ashlynblack/psx-mod/research/notes/2024-06-29.pdf

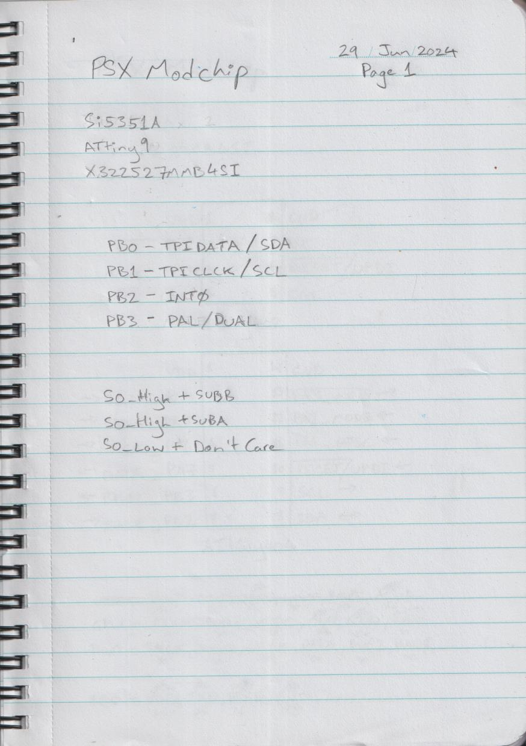
[picture p7: page 1]
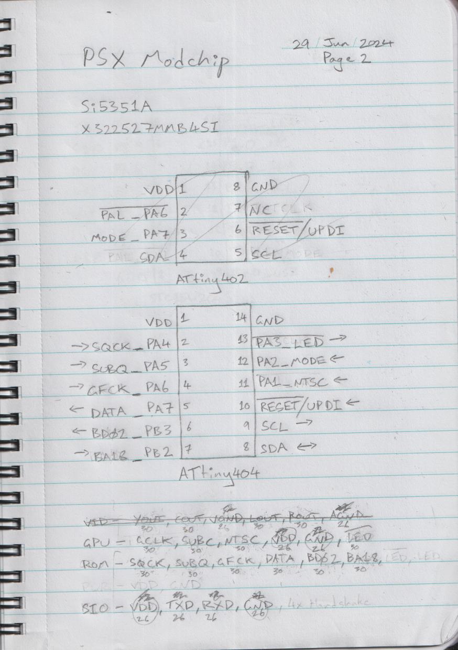
[picture p8: page 2]
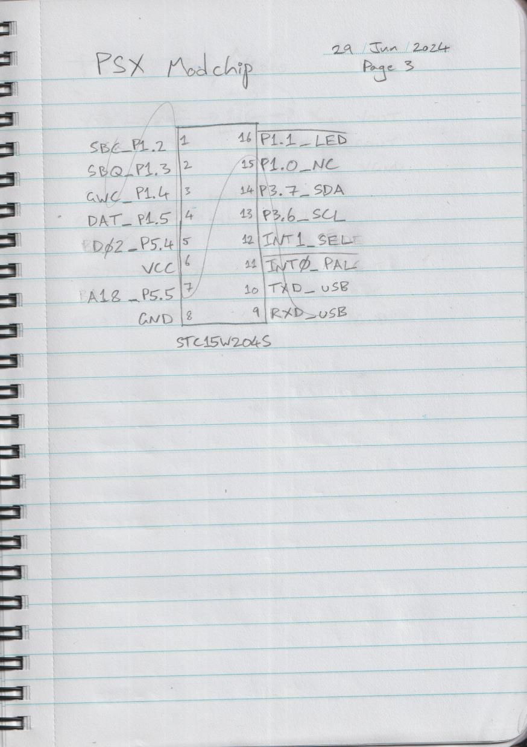
[picture p9: page 3]
