ashlynblack/psx-mod/artifacts/back.png

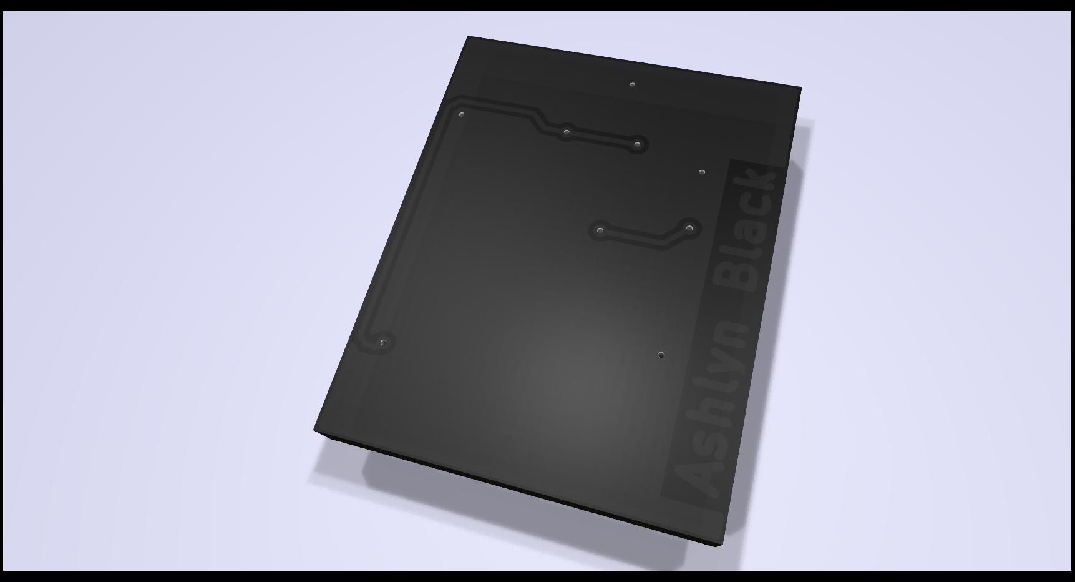
artifacts/back.png
