ashlynblack/psx-mod/artifacts/front.png

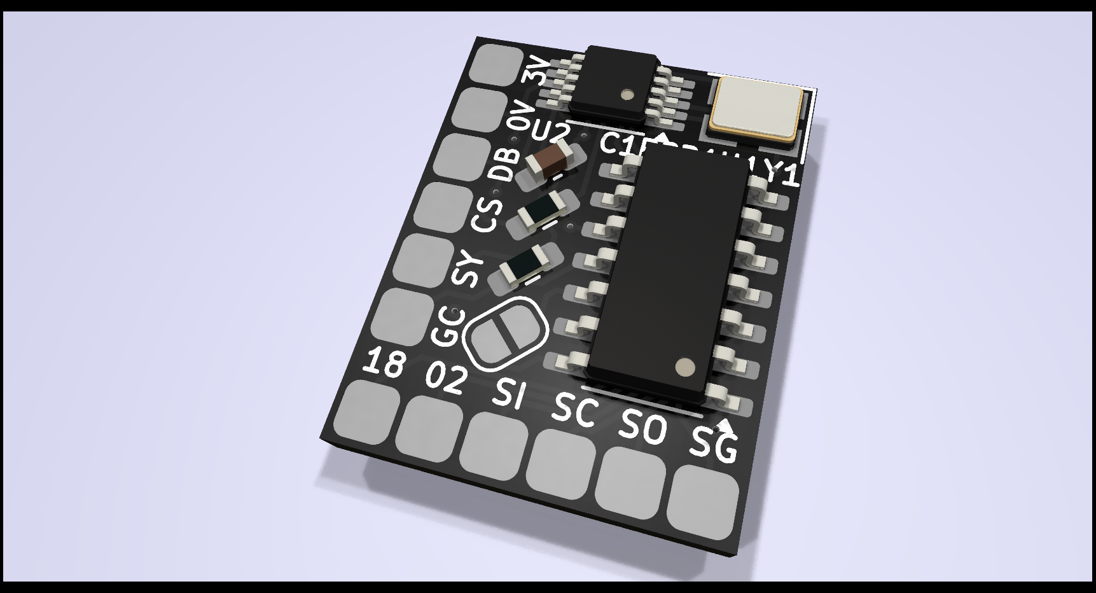
artifacts/front.png
