ashlynblack/psx-mod/research/diagrams/ps1-usb-link-cable.png

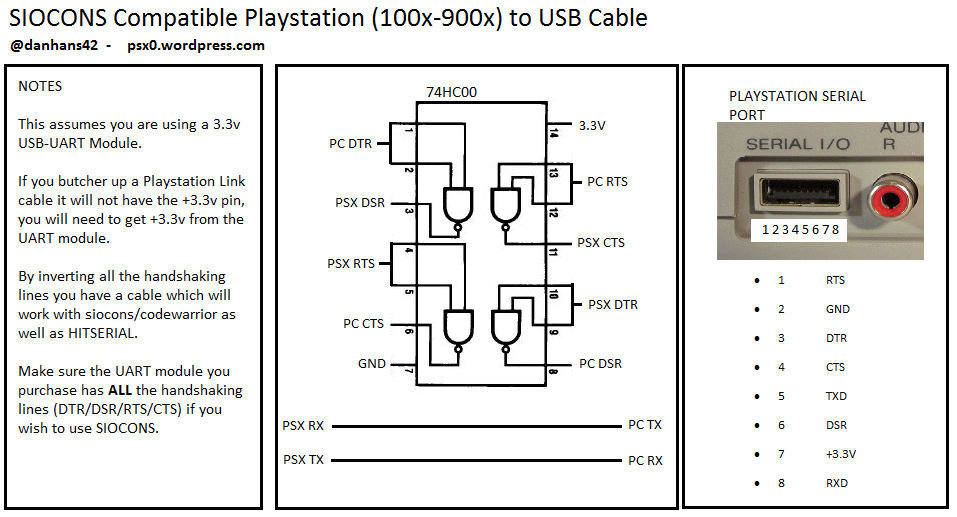
research/diagrams/ps1-usb-link-cable.png
