ashlynblack/psx-mod/artifacts/bom.csv

Reference | Value | Footprint | Qty
C1 | 10µF | Capacitor_SMD:C_0603_1608Metric_Pad1.08x0.95mm_HandSolder | 1
R1 | 220Ω | Resistor_SMD:R_0603_1608Metric_Pad0.98x0.95mm_HandSolder | 1
R2 | 2.2kΩ | Resistor_SMD:R_0603_1608Metric_Pad0.98x0.95mm_HandSolder | 1
U1 | ATtiny414-SS | Package_SO:SOIC-14_3.9x8.7mm_P1.27mm | 1
U2 | Si5351A-B-GT | Package_SO:MSOP-10_3x3mm_P0.5mm | 1
Y1 | 27MHz | Crystal:Crystal_SMD_3225-4Pin_3.2x2.5mm | 1
