ashlynblack/psx-mod/artifacts/layout.pdf

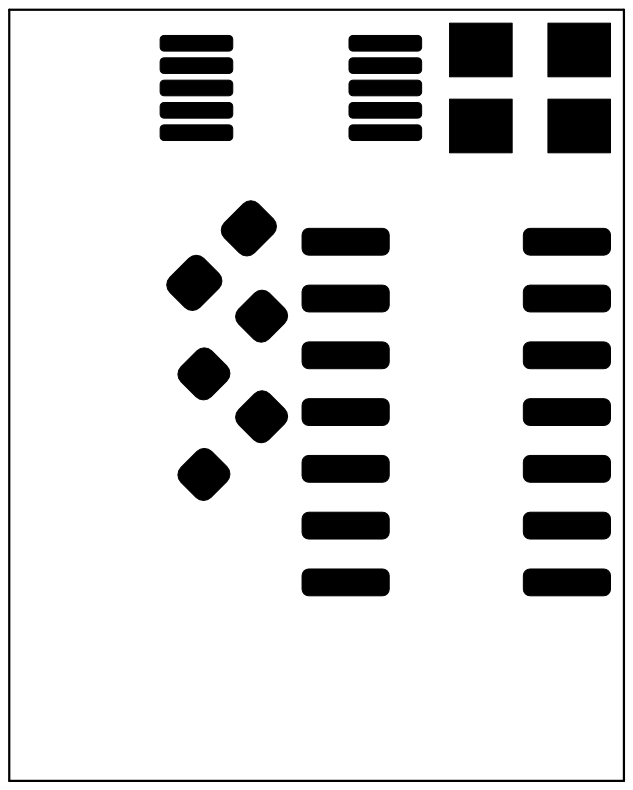
[picture p13: page 1]
D Date: 2024-07-09 KiCad; E.D.A. 8.0.4 Size: A4; Rev: 0; File: psx-mod.kicad_pcb Sheet: Ashlyn; Black

Id: 1/1 Title: PSX Modchip

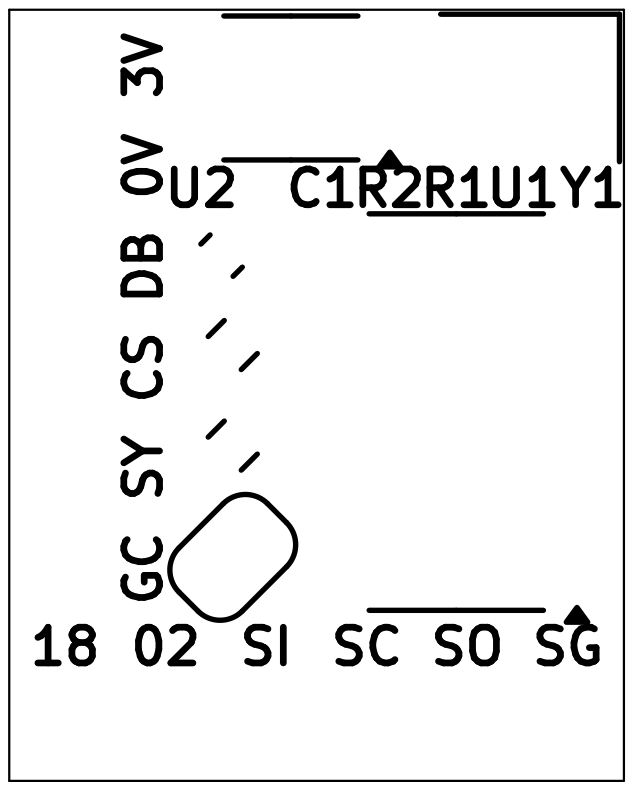
[picture p14: page 2]
D Date: 2024-07-09 KiCad; E.D.A. 8.0.4 Size: A4; Rev: 0; File: psx-mod.kicad_pcb Sheet: Ashlyn; Black SY GC ⁰V ³V

Id: 1/1 Title: PSX Modchip

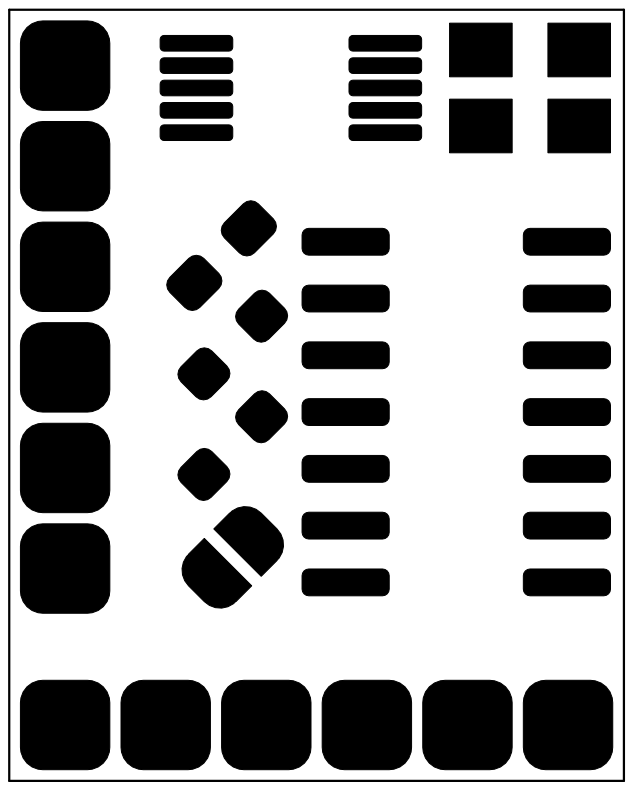
[picture p15: page 3]
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

Id: 1/1 Title: PSX Modchip

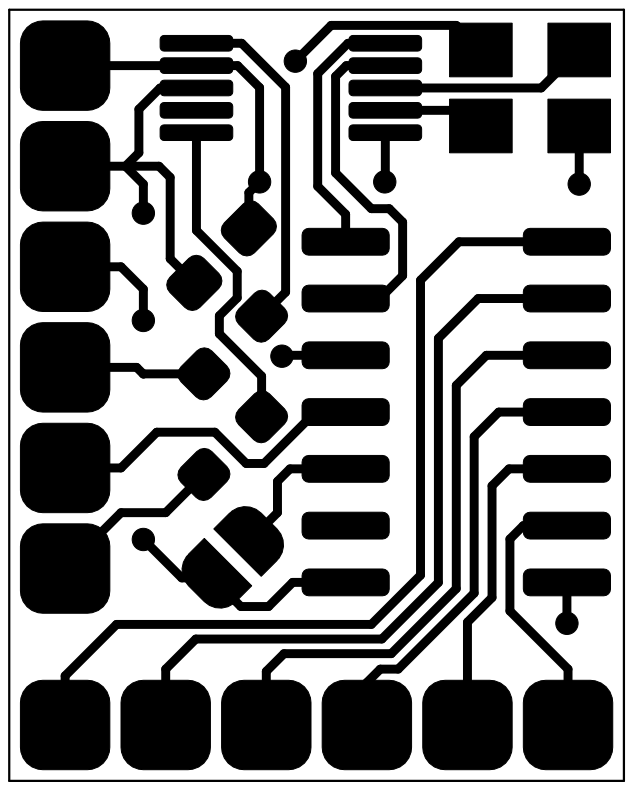
[picture p16: page 4]
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

Id: 1/1 Title: PSX Modchip

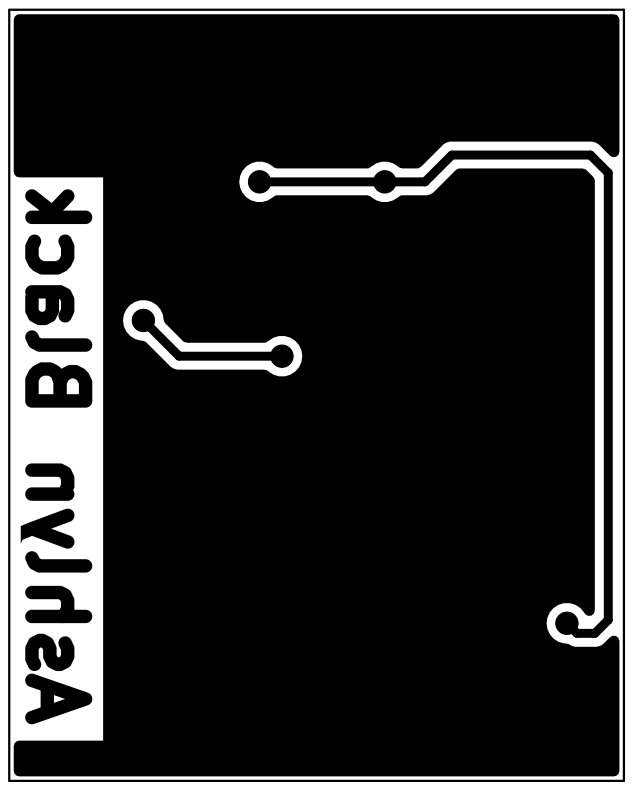
[picture p17: page 5]
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

Id: 1/1 Title: PSX Modchip

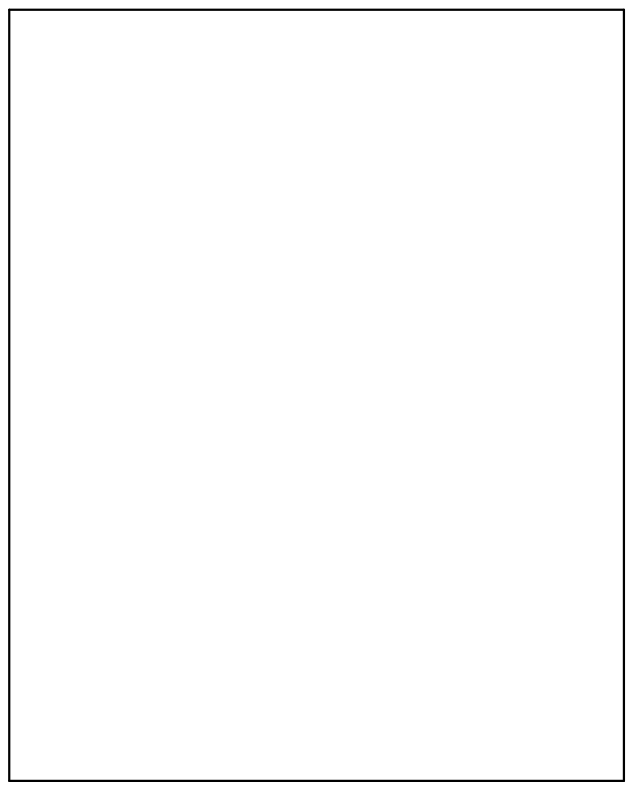
[picture p18: page 6]
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

Id: 1/1 Title: PSX Modchip

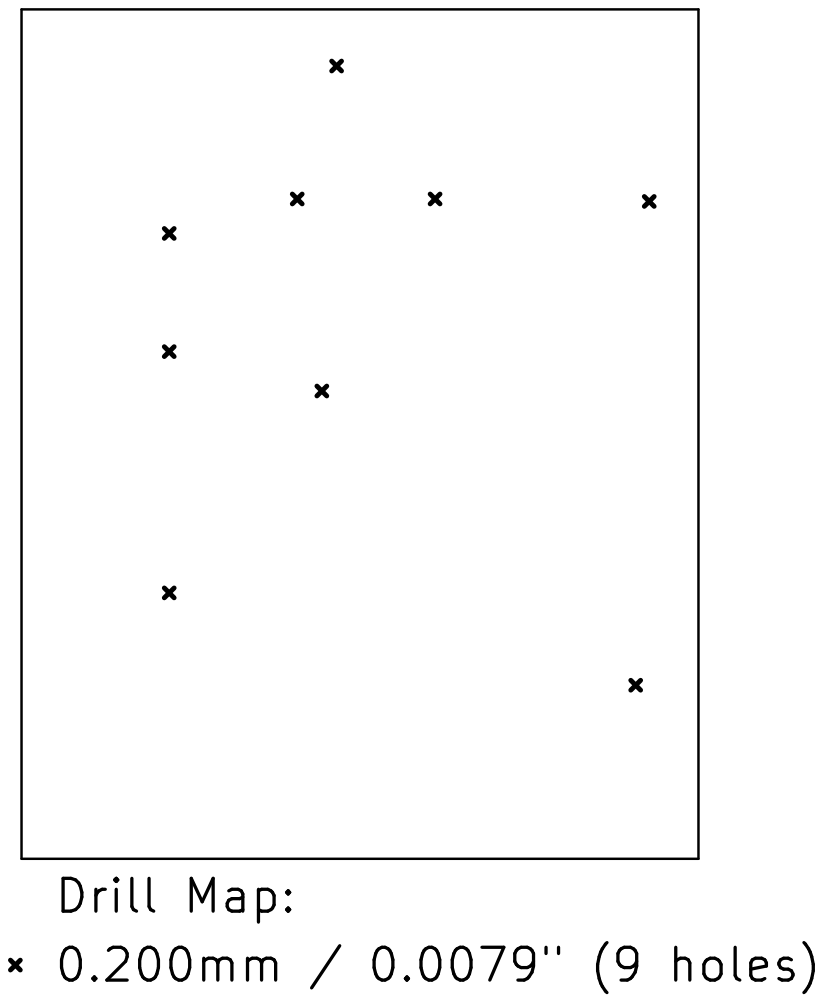
[picture p19: page 7]
Drill; Map:; holes)
