ashlynblack/psx-mod/artifacts/schematic.pdf

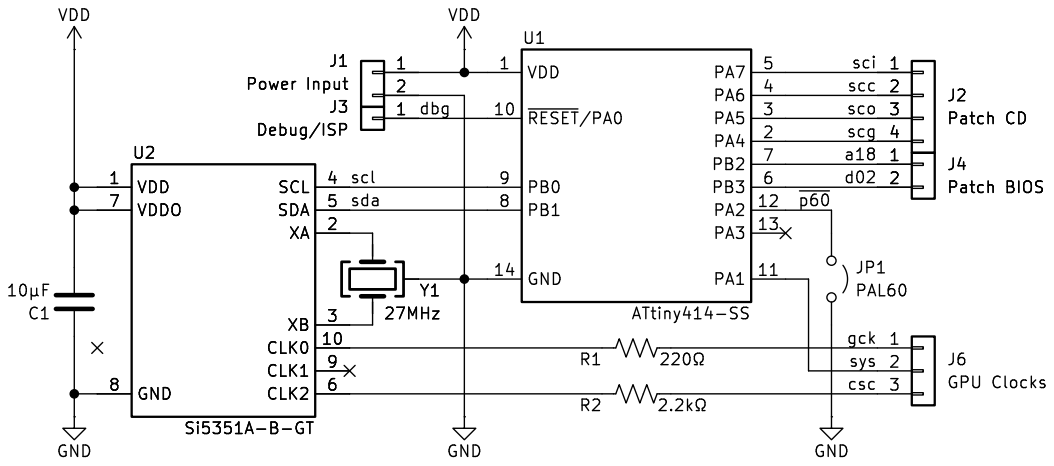
[picture p20: page 1]

Id: 1/1 Title: PSX Modchip
