ashlynblack/psx-mod/circuitry/psx-mod.kicad_pcb

## KiCad design circuitry/psx-mod.kicad_pcb (2024-07-27)

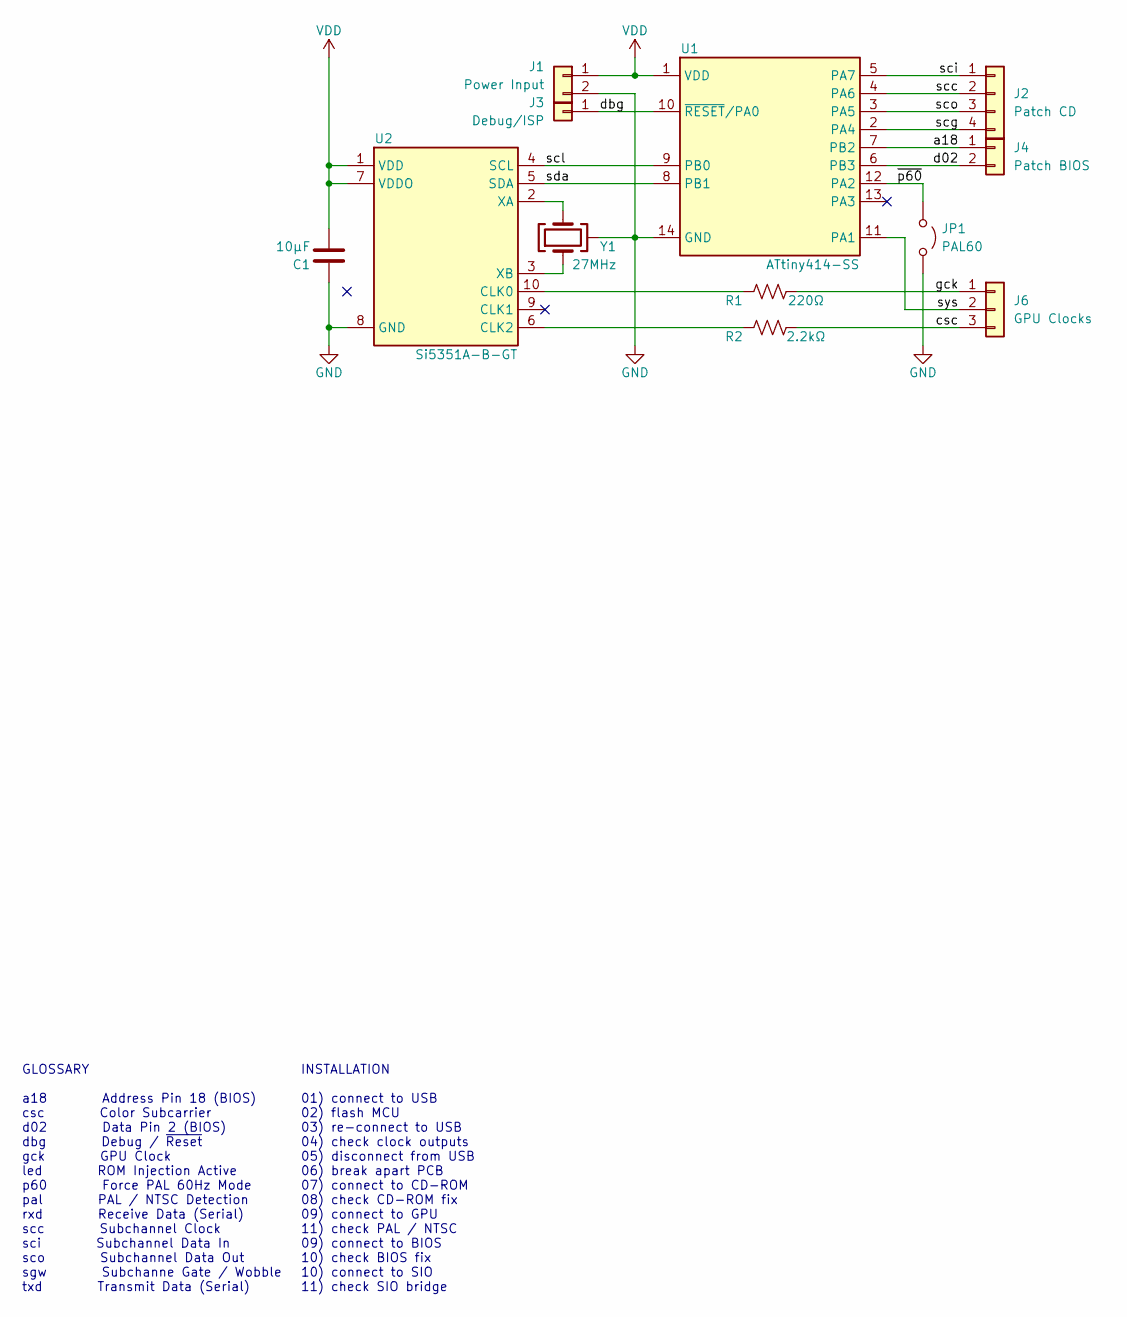
[picture p27: schematic psx-mod.kicad_sch, PSX Modchip]

Parts:
C1: 10µF; C_0603_1608Metric_Pad1.08x0.95mm_HandSolder
J1, J4: Conn_01x02; CONN-SMD_2P
J2: Conn_01x04; CONN-SMD_4P
J3: Conn_01x01; CONN-SMD_1P
J6: Conn_01x03; CONN-SMD_3P
JP1: Jumper_2_Open; SolderJumper-2_P1.3mm_Open_RoundedPad1.0x1.5mm
R1: 220Ω; R_0603_1608Metric_Pad0.98x0.95mm_HandSolder
R2: 2.2kΩ; R_0603_1608Metric_Pad0.98x0.95mm_HandSolder
U1: ATtiny414-SS; SOIC-14_3.9x8.7mm_P1.27mm
U2: Si5351A-B-GT; MSOP-10_3x3mm_P0.5mm
Y1: 27MHz; Crystal_SMD_3225-4Pin_3.2x2.5mm

Connections:
/a18: J4.1, U1.7 (PB2)
/csc: J6.3, R2.2
/d02: J4.2, U1.6 (PB3)
/dbg: J3.1, U1.10 (~RESET/PA0)
/gck: J6.1, R1.2
/scc: J2.2, U1.4 (PA6)
/scg: J2.4, U1.2 (PA4)
/sci: J2.1, U1.5 (PA7)
/scl: U1.9 (PB0), U2.4 (SCL)
/sco: J2.3, U1.3 (PA5)
/sda: U1.8 (PB1), U2.5 (SDA)
/sys: J6.2, U1.11 (PA1)
/~p60: JP1.1 (A), U1.12 (PA2)
GND: C1.2, J1.2, JP1.2 (B), U1.14 (GND), U2.8 (GND), Y1.2 (GND), Y1.4 (GND)
unnamed: R1.1, U2.10 (CLK0)
unnamed: R2.1, U2.6 (CLK2)
unnamed: U2.2 (XA), Y1.3
unnamed: U2.3 (XB), Y1.1
VDD: C1.1, J1.1, U1.1 (VDD), U2.1 (VDD), U2.7 (VDDO)

Notes on the sheet:
GLOSSARY a18 Address Pin 18 (BIOS) csc Color Subcarrier d02 Data Pin 2 (BIOS) dbg Debug / ~{Reset} gck GPU Clock led ROM Injection Active p60 Force PAL 60Hz Mode pal PAL / NTSC Detection rxd Receive Data (Serial) scc Subchannel Clock sci Subchannel Data In sco Subchannel Data Out sgw Subchanne Gate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
INSTALLATION 01) connect to USB 02) flash MCU 03) re-connect to USB 04) check clock outputs 05) disconnect from USB 06) break apart PCB 07) connect to CD-ROM 08) check CD-ROM fix 09) connect to GPU 11) check PAL / NTSC 09) connect to BIOS 10) check BIOS fix 10) connect to SIO 11) check SIO bridge

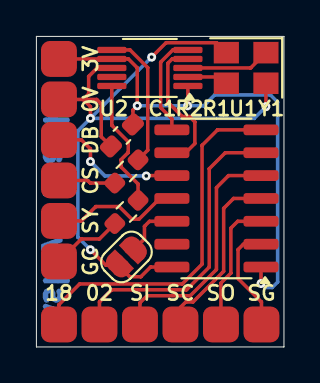
[picture p28: board psx-mod.kicad_pcb from above]

Board: 2 copper layers, 13.8 x 17.2 mm, 12 parts (0 on the bottom side), 19 nets.
