ashlynblack/psx-mod/(commit log)

2024-06-03 Ignored KiCAD backups.
2024-06-03 Initial schematic.
    [psx-mod.kicad_pcb, psx-mod.kicad_sch]
2024-07-09 Completed schematic and layout (badly).
    [psx-mod.kicad_pcb, psx-mod.kicad_sch]
2024-07-09 Rendered model, generated gerbers, schematic and layout.
    [bom.csv]
2024-07-10 Generated interactive bill of materials.
    [psx-mod.kicad_pcb]
2024-07-27 Ignore KiCAD backup files.
2024-07-27 Added articles on I2C to research.
2024-07-27 Completed schematic and layout.
    [psx-mod.kicad_pcb, psx-mod.kicad_sch]
2024-07-27 Generated artifacts.
    [bom.csv]
